PyCubed-Mini/SatelliteMechanical/README.md

# Satellite Mechanical
Mechanical structure of the satellite hardware. CAD archive and 3D printing jobs.

All 3D CAD design is done in Fusion 360. Archives of the "releases" when we produce 3D print jobs will be mantained here.
