PyCubed-Mini/SatelliteMechanical/Antenna Models/Antenna Bracket.stl

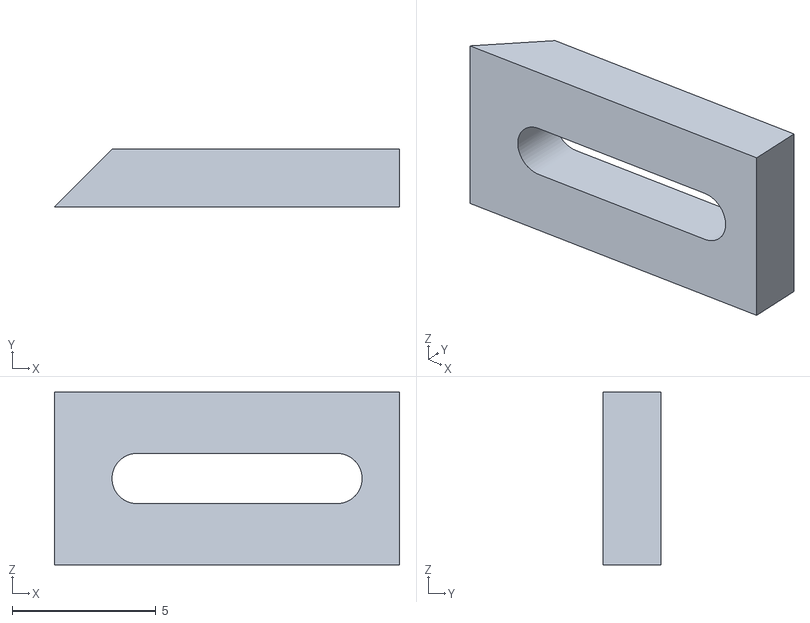
[picture p1: CAD file, 2022-10-31]
Antenna Models/Antenna Bracket.stl
12.0 x 2.00 x 6.00
