PyCubed-Mini/SatelliteMechanical/Rails/Y+ Rails.step

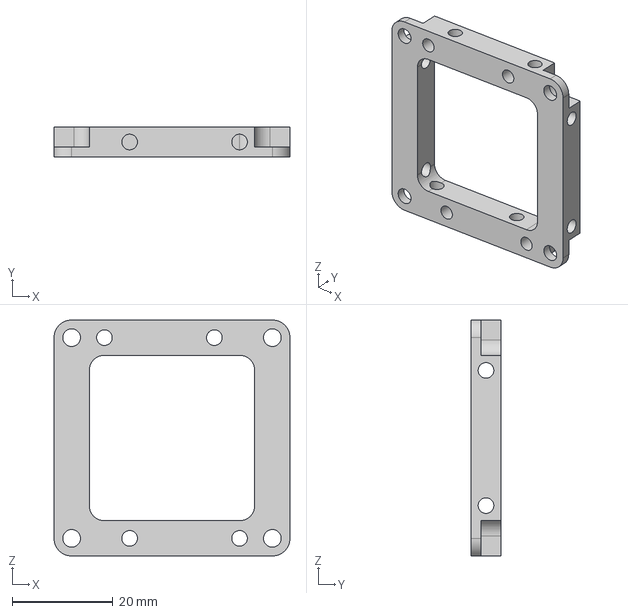
[picture p2: CAD file, 2023-06-20]
Rails/Y+ Rails.step
46.8 x 6.00 x 46.8 mm
