PyCubed-Mini/SatelliteMechanical/Satellite Base/Switch Plug.step

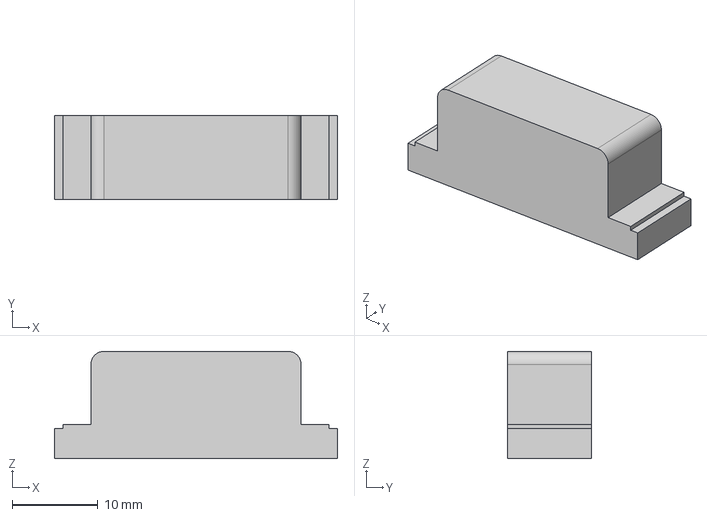
[picture p3: CAD file, 2023-06-20]
Satellite Base/Switch Plug.step
33.0 x 9.80 x 12.5 mm
