PyCubed-Mini/SatelliteMechanical/Antenna Models/Antenna_Bender_45deg.stl

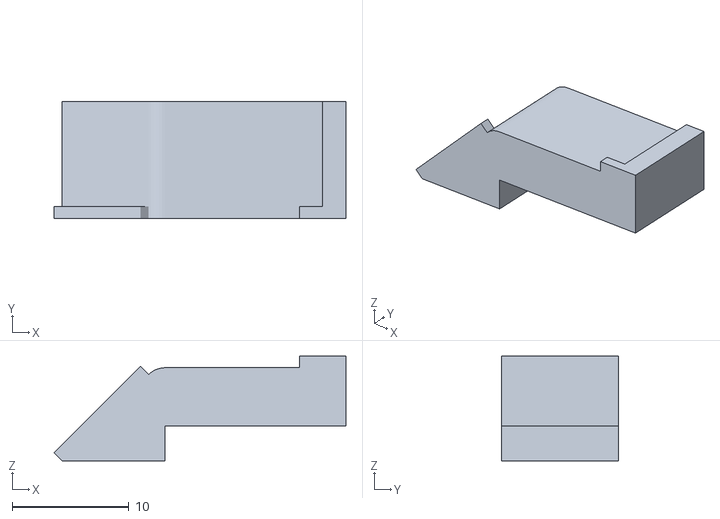
[picture p4: CAD file, 2022-08-31]
Antenna Models/Antenna_Bender_45deg.stl
25.0 x 10.0 x 9.00
