PyCubed-Mini/SatelliteMechanical/Satellite Base/Base Holder.step

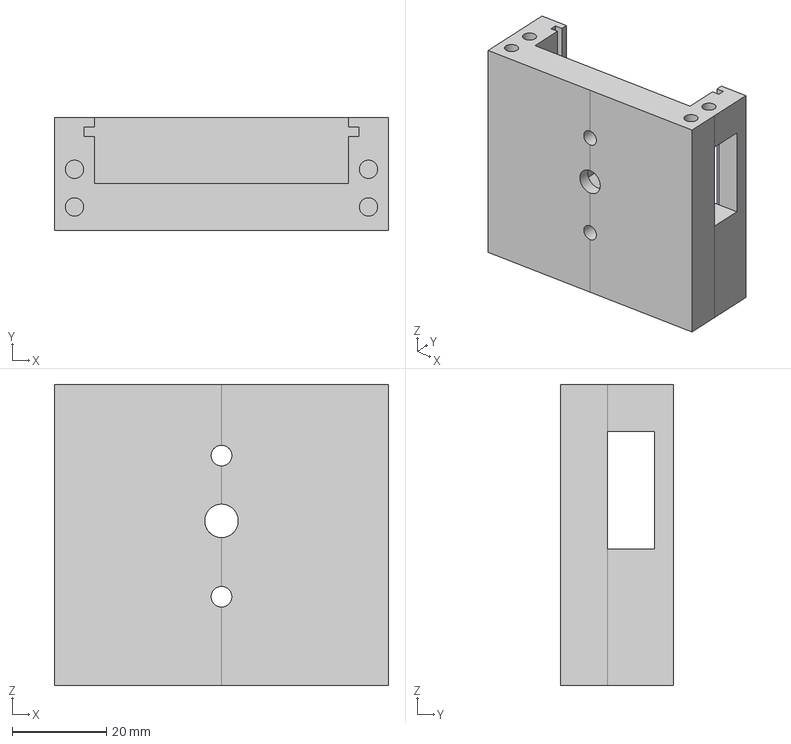
[picture p5: CAD file, 2023-06-20]
Satellite Base/Base Holder.step
71.0 x 24.0 x 64.0 mm
