PyCubed-Mini/SatelliteMechanical/Antenna Models/Antenna_Bender_90deg.stl

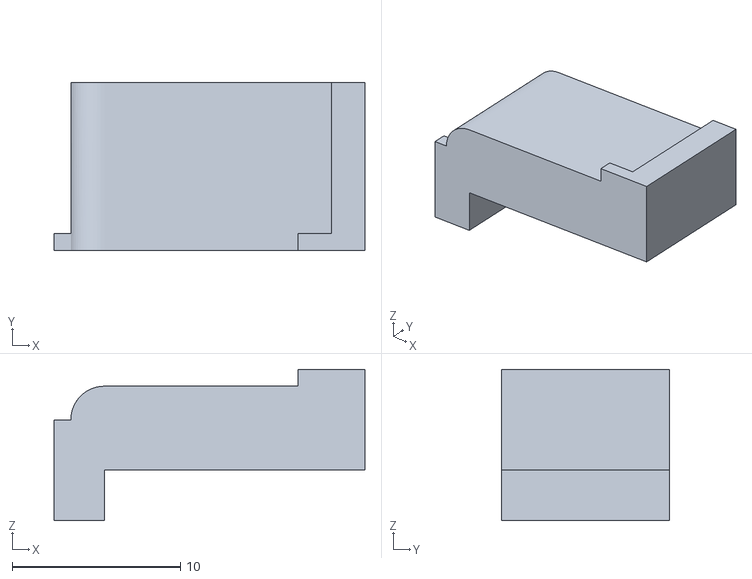
[picture p6: CAD file, 2022-08-31]
Antenna Models/Antenna_Bender_90deg.stl
18.5 x 10.0 x 9.00
