PyCubed-Mini/SatelliteMechanical/Satellite Base/Base Cap.step

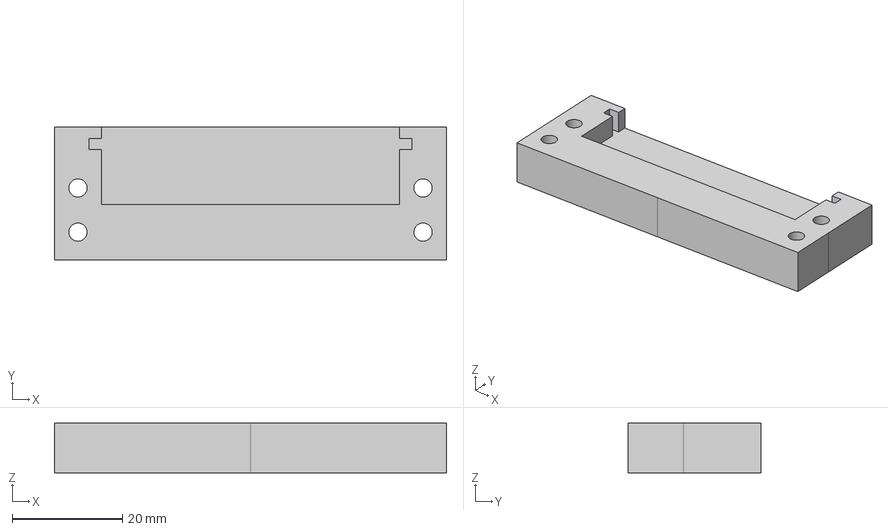
[picture p7: CAD file, 2023-06-20]
Satellite Base/Base Cap.step
71.0 x 24.0 x 9.00 mm
