PyCubed-Mini/SatelliteMechanical/(list of files, cad)

Other CAD files:
Rails/Y+ Rails.stl
Rails/Y- Rails.step
Rails/Y- Rails.stl
Satellite Base/Base Cap.stl
Satellite Base/Base Holder.stl
Satellite Base/Switch Plug.stl
