PyCubed-Mini/SatelliteMechanical/Rails/Y+ Rails Drawing.pdf

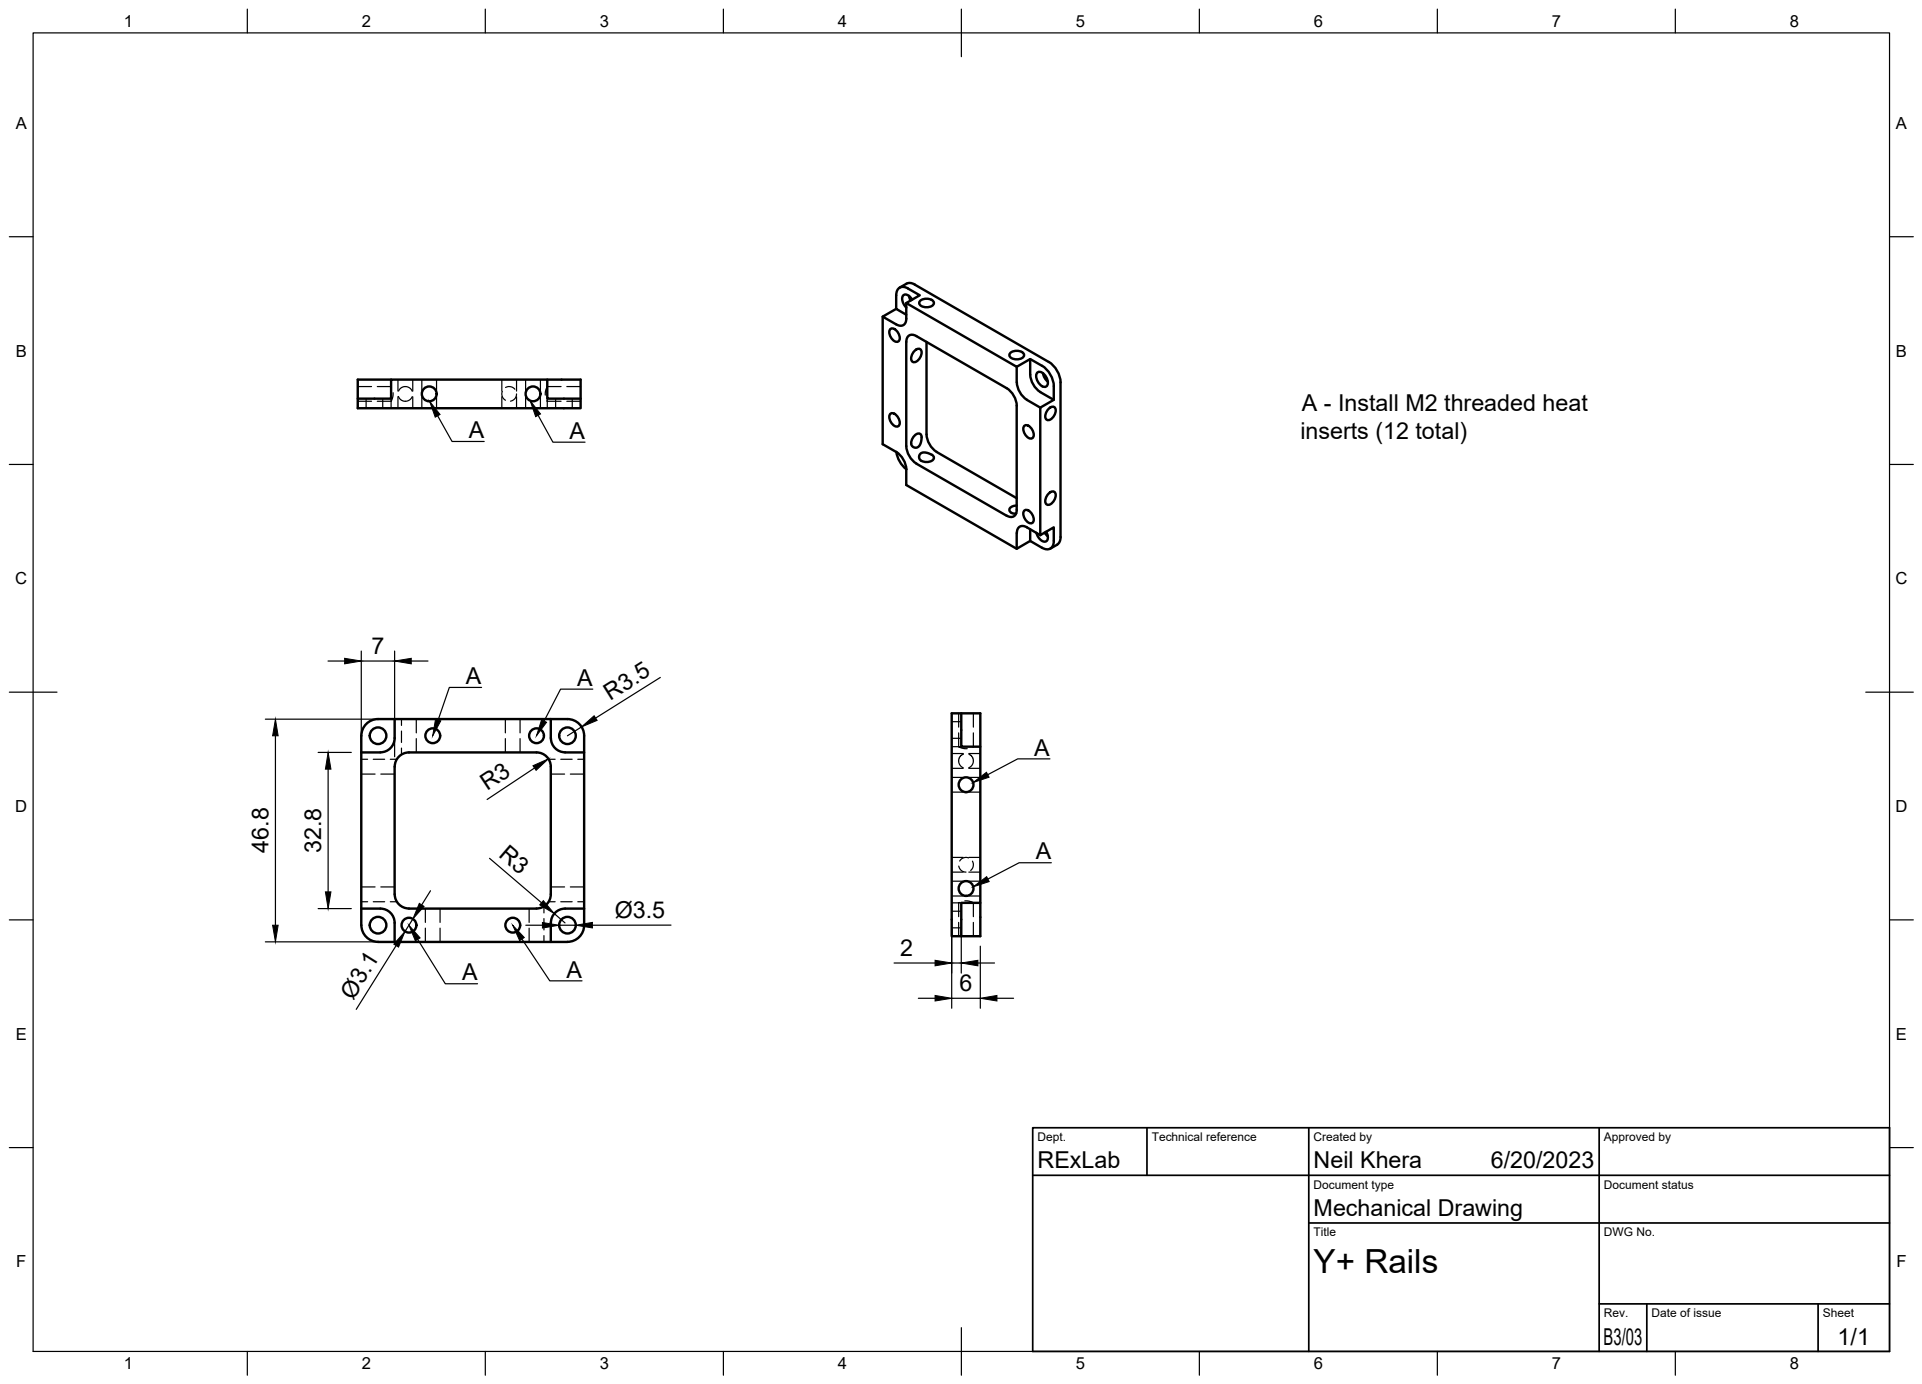
[picture p8: page 1]
Title; DWG No.; Rev.; Date of issue; Sheet; Y+ Rails

A - Install M2 threaded heat
inserts (12 total)

Dept. RExLab | Technical reference | Created by Neil Khera 6/20/2023 | Approved by

Document type Mechanical Drawing | Document status
