PyCubed-Mini/SatelliteMechanical/Rails/Y- Rails Drawing.pdf

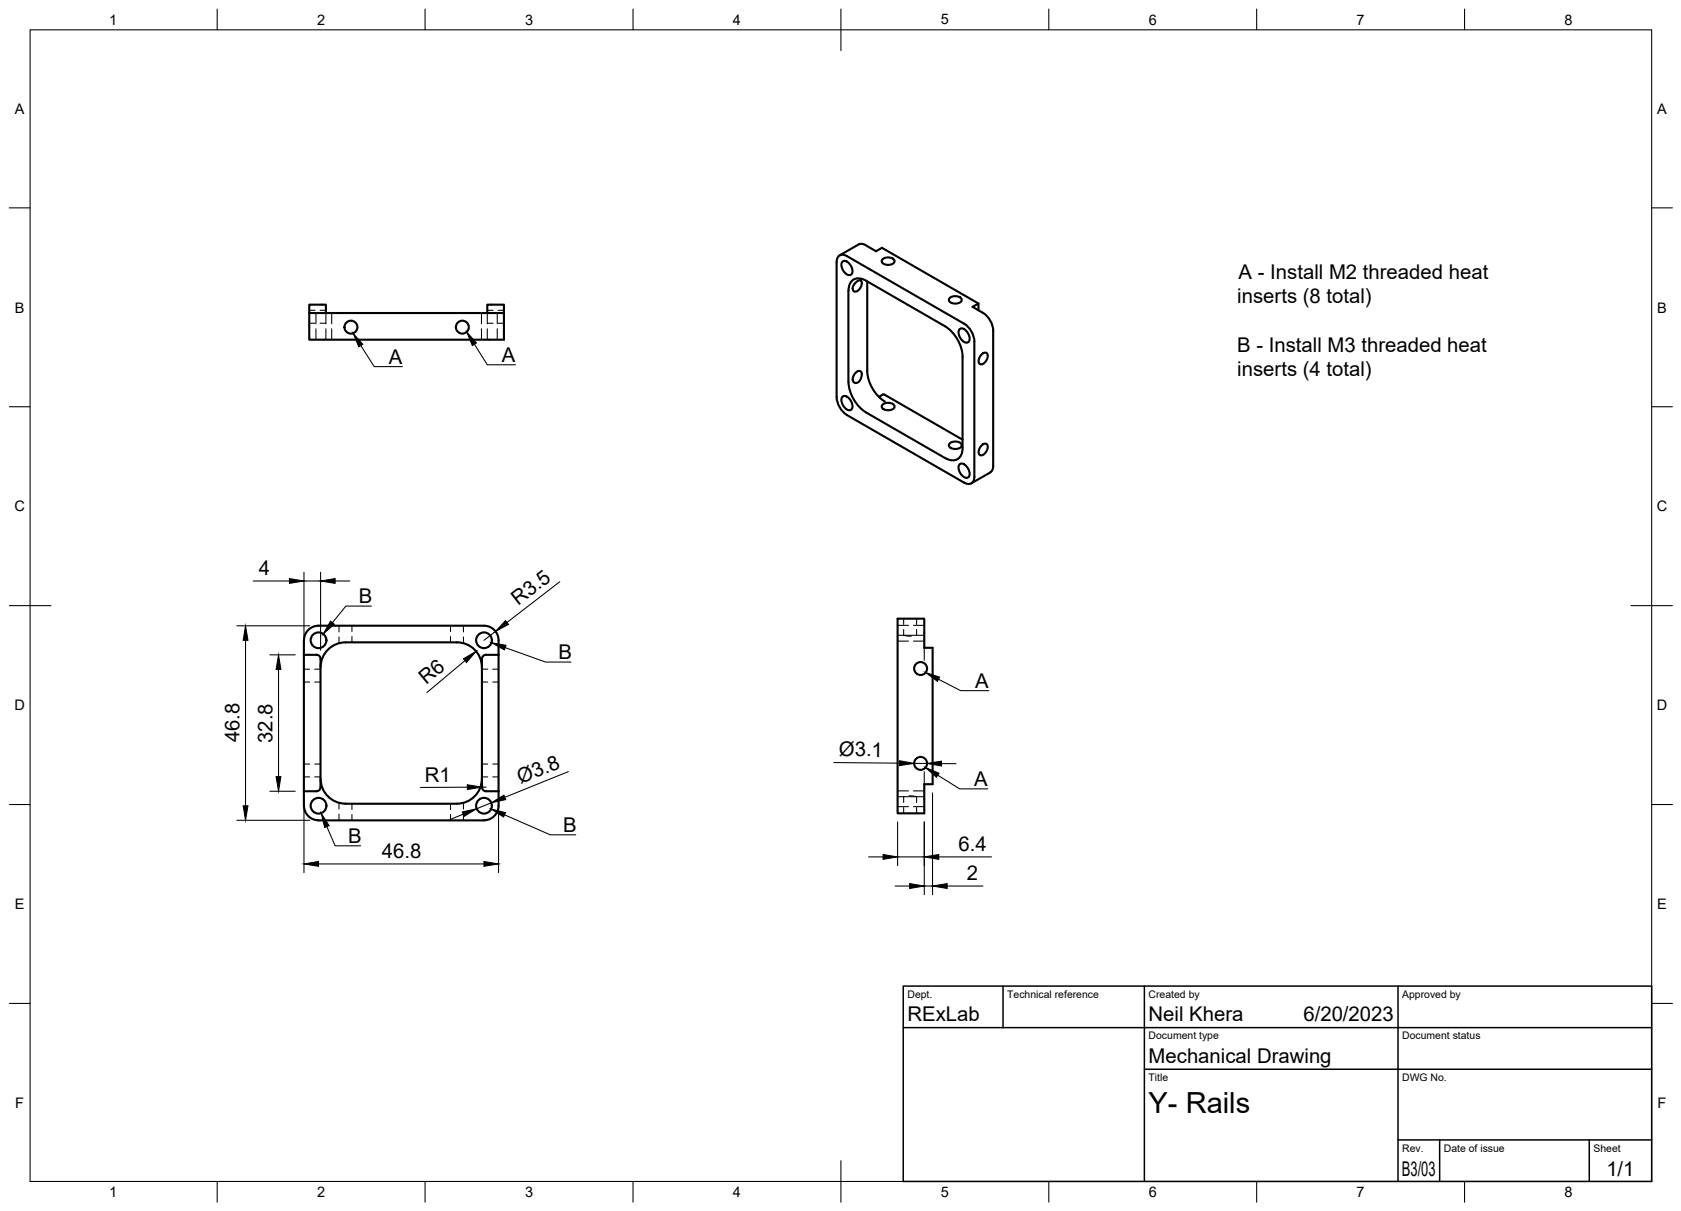
[picture p9: page 1]
Title; DWG No.; Rev.; Date of issue; Sheet; Y- Rails

A - Install M2 threaded heat
inserts (8 total)

B - Install M3 threaded heat
inserts (4 total)

Dept. RExLab | Technical reference | Created by Neil Khera 6/20/2023 | Approved by

Document type Mechanical Drawing | Document status
