PyCubed-Mini/SatelliteMechanical/(threads)

Thread 4 (2022-02-15):

Full assembly

jbwillis, 2022-02-15:
Assemble the satellite using current hardware, documenting the process and any pain points.

jbwillis, 2022-02-22:
Completed as much of an assembly as we could on 18-Feb-2022 and 21-Feb-2022. Found the following problems, which should become independent issues

- [ ] Flat flex cable is very difficult to route and much simpler options can be created.
- [ ] -Y flat flex connector interferes with rails
- [ ] Inductors on Z boards interfere with battery enclosure
- [ ] Battery wires in enclosure get in the way
- [ ] Mainboard USB port can't actually be plugged into with a USB cable due to Z board interference.
- [ ] The only mechanical attachment of the camera and lens is through the tabs on the camera board. Seems prone to vibration issues.
- [ ] Slots for camera and mainboard are very shallow - increase depth by 1-2mm
- [ ] Using flat flex between camera and mainboard is not well thought through - a 1.27mm stacking header could work instead.

Closed 2022-02-23.

Thread 5 (2022-02-23):

Better slots for holding main and camera boards

jbwillis, 2022-02-23:
The current slots for the main and camera boards are too shallow to provide a secure mechanical connection.

Closed 2022-05-16.

Thread 7 (2022-05-16):

Replace battery standoffs with 6mm and camera/mainboard/radio standoffs to 8mm

jbwillis, 2022-05-16:

g-savant, 2022-05-17:
Replaced all standoffs

Closed 2022-05-17.

Thread 8 (2022-05-17):

Test assembly of stack structure

jbwillis, 2022-05-17:
Do a test assembly of the stack structure
- [ ] 3D print all of the parts
- [ ] install heat inserts
- [ ] assemble.

Closed 2023-06-20.

Thread 9 (2022-05-19):

Antenna mechanical tests

jbwillis, 2022-05-19:
- [x] Assemble current (45 degree bend) antenna design.
- [x] Note weaknesses in the design.
- [ ] Test wrapping it around the structure and tying off to the burn wire using fishing line.

Closed 2023-06-20.

Thread 10 (2022-06-10):

Storage box

jbwillis, 2022-06-10:
Need a box to store the assembled satellite in to keep it powered off when not in use. The box should mate with the satellite along the -Y rails, causing the separation switches to close.

jbwillis, 2022-06-10:
The box should also allow us to connect a power supply for charging the satellite.

g-savant, 2022-06-17:
Created preliminary rev in Fusion

Closed 2023-06-20.
