PyCubed-Mini/SatelliteMechanical/(commit log)

2022-06-27 3D models for rails and base holder
    [pocketqube_base.stl, rails_Y+.stl, rails_Y-.stl]
2022-08-31 Antenna bender
    [Antenna_Bender_45deg.stl, Antenna_Bender_90deg.stl]
2022-10-26 reduce hole diameters and add fillets
    [rails_Y+.stl, rails_Y-.stl]
2022-10-26 files for Windform
    [rails_Y+.step, rails_Y-.step]
2022-10-28 new base ideas with better bottom access
    [base_open_bottom.stl, base_with_screw_holes.stl]
2022-10-31 antenna bracket
    [Antenna Bracket.stl]
2023-06-20 Updated all models to Rev B3
    [Antenna Bracket.stl, Antenna_Bender_45deg.stl, Antenna_Bender_90deg.stl, Base Cap.step, Base Cap.stl, Base Holder.step, Base Holder.stl, Switch Plug.step]
